saper6569/Sound-System/LtSpice/CrossoverFilterAnalysis.asc

C1: cap; 0.1µ
C2: cap; 0.1µ
C3: cap; 0.1µ
C4: cap; 0.1µ
C5: cap; 0.1µ
C6: cap; 47n
C7: cap; 47n
C8: cap; 0.1µ
R1: res; 11k
R2: res; 22k
R3: res; 11k
R4: res; 22k
R5: res; 1k
R6: res; 18k
R7: res; 30k
R8: res; 30k
R9: res; 18k
R10: res; 1k
U1: opamp
U2: opamp
U3: opamp
U4: opamp
V1: voltage; AC 1
Named nets: 0, Highs-Out, Lows-Out
.lib opamp.sub
.ac dec 20 20 20k
