saper6569/Sound-System/LtSpice/SoundSystemSpice.asc

C1: cap; 100n
C2: cap; 100n
C3: cap; 100n
C4: cap; 100n
C5: cap; 100n
C6: cap; 47n
C7: cap; 100n
C8: cap; 47n
C9: cap; 100n
C10: cap; 100n
C11: cap; 100n
C12: cap; 47n
C13: cap; 100n
C14: cap; 100n
C15: cap; 100n
C16: cap; 47n
C17: cap; 100p
C18: cap; 100p
C19: cap; 10µ
C20: cap; 10µ
C21: cap; 47n
C22: cap; 4.7n
C23: cap; 22n
C24: cap; 1n
C25: cap; 4.7n
C26: cap; 47n
C27: cap; 4.7n
C28: cap; 22n
C29: cap; 4.7n
C30: cap; 1n
C31: cap; 10µ
R1: res; 11k
R2: res; 22k
R3: res; 11k
R4: res; 22k
R5: res; 1k
R6: res; 18k
R7: res; 30k
R8: res; 30k
R9: res; 18k
R10: res; 1k
R11: res; 11k
R12: res; 22k
R13: res; 18k
R14: res; 1k
R15: res; 1k
R16: res; 30k
R17: res; 11k
R18: res; 22k
R19: res; 30k
R20: res; 1k
R21: res; 1k
R22: res; 18k
R23: res; 1k
R24: res; 1k
R25: res; {100k*b}
R26: res; {100k*(1-b)}
R27: res; 10k
R28: res; {100k*m}
R29: res; {500k*t}
R30: res; 10k
R31: res; 10k
R32: res; {100k*(1-m)}
R33: res; 3.3k
R34: res; 3.3k
R35: res; {500k*(1-t)}
R36: res; 1.8k
R37: res; 1.8k
R38: res; 270
R39: res; {100k*b}
R40: res; {100k*(1-b)}
R41: res; 10k
R42: res; 10k
R43: res; 10k
R44: res; {100k*m}
R45: res; {100k*(1-m)}
R46: res; 3.3k
R47: res; 3.3k
R48: res; {500k*t}
R49: res; {500k*(1-t)}
R50: res; 1.8k
R51: res; 1.8k
R52: res; 270
R53: res; 1k
R56: res; {10k*v}
R57: res; {10k*(1-v)}
R58: res; {10k*v}
R59: res; {10k*(1-v)}
U1: opamp
U2: opamp
U3: opamp
U4: opamp
U5: opamp
U6: opamp
U7: opamp
U8: opamp
U9: opamp
U10: opamp
U11: opamp
U12: opamp
U13: opamp
V1: voltage; wavefile="Daft-Punk-One-More-Time.wav" chan=1
V2: voltage; wavefile="Daft-Punk-One-More-Time.wav" chan=0
Named nets: 0, Left, Right, Left-Out, Right-Out, Sub-Out
.param b=0.5
.param m=0.5
.param t=0.5
 
.param v 0.9
 
.wave "l+r.wav" 16 44.1k V(Left-Out) V(Right-Out)
.wave "bass.wav" 16 44.1k V(Sub-Out) 
BLEFT  Lmix 0 V=V(Left-Out)+V(Sub-Out)
BRIGHT Rmix 0 V=V(Right-Out)+V(Sub-Out)
 
.wave "together.wav" 16 44.1k V(Lmix) V(Rmix)
 
.lib opamp.sub
.tran 10
Parameters b, m, t control the active equalizer where the letters represent bass, mid and treble respectively.
Parameter v controls the volume.
Change these parameters around to see the equalizer and volume control work.
Make sure to keep parameters between 0 and 1 exclusive.
 
For changing the input audio: 
1. Place a wav file in the same directory as the project
2. Change the directives under V1 and V2 to your wav file name, but keep chan=1 and chan=0
3. Set the .tran to be longer than the length of the wav file
 
I highly recommend trimming your audio, as simulation often takes a long time.
3 Band Baxandall 
Eqaulizer
2 Way Crossover
Subwoofer 
L+R Summer
Volume 
Control
Input
Buffer
