saper6569/Sound-System/Kicad/SoundSystem.kicad_pcb

## KiCad design Kicad/SoundSystem.kicad_pcb (2026-11-13)

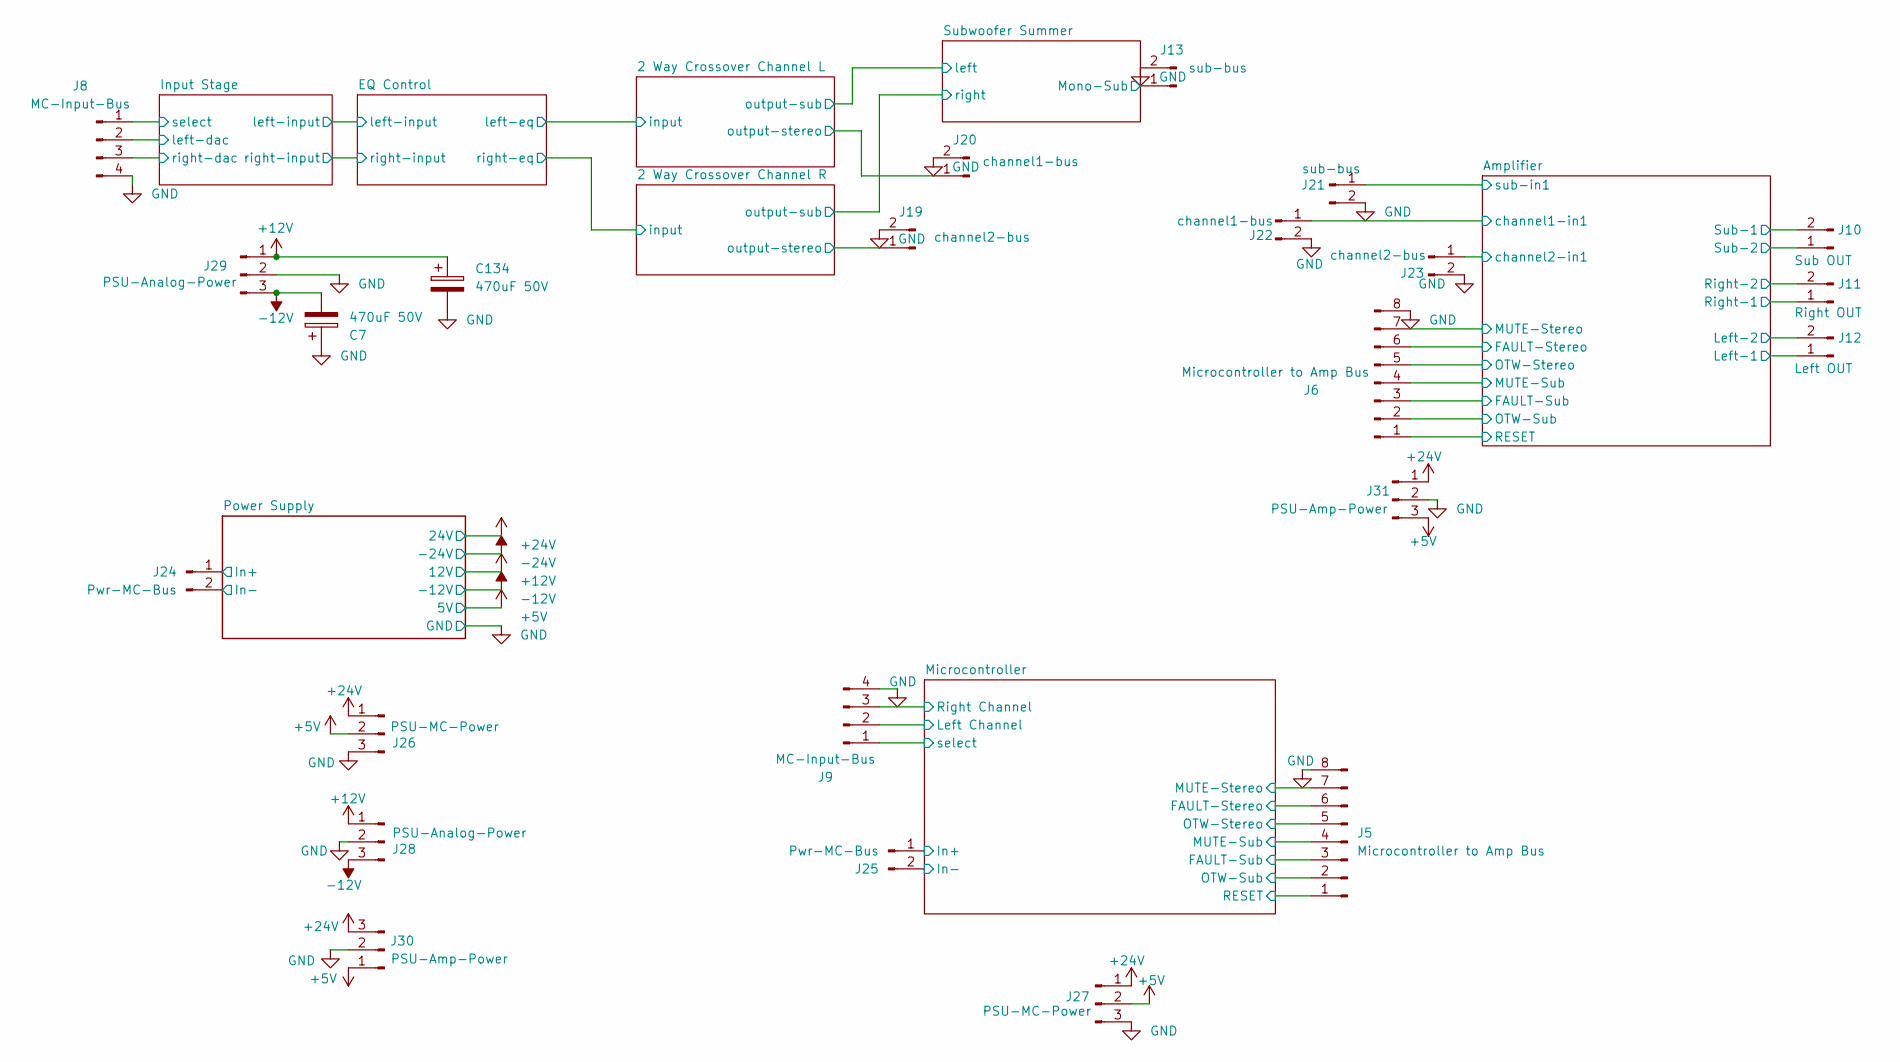
[picture p1: schematic SoundSystem.kicad_sch]

Parts:
C7, C134: 470uF 50V; CP_Radial_D12.5mm_P5.00mm; MPN NXH 50V470 12.5*20; LCSC C165672
J5, J6: Microcontroller to Amp Bus; PinHeader_1x08_P2.54mm_Vertical; MPN PZ254V-11-08P; LCSC C492407
J8, J9: MC-Input-Bus; PinHeader_1x04_P2.54mm_Vertical; MPN PZ254V-11-04P; LCSC C492403
J10: Sub OUT; TerminalBlock_Phoenix_MKDS-1,5-2-5.08_1x02_P5.08mm_Horizont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; MPN KF128-5.08-2P-AA; LCSC C474952
J11: Right OUT; TerminalBlock_Phoenix_MKDS-1,5-2-5.08_1x02_P5.08mm_Horizont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; MPN KF128-5.08-2P-AA; LCSC C474952
J12: Left OUT; TerminalBlock_Phoenix_MKDS-1,5-2-5.08_1x02_P5.08mm_Horizont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; MPN KF128-5.08-2P-AA; LCSC C474952
J13, J21: sub-bus; PinHeader_1x02_P2.54mm_Vertical; MPN PZ254V-11-02P; LCSC C492401
J19, J23: channel2-bus; PinHeader_1x02_P2.54mm_Vertical; MPN PZ254V-11-02P; LCSC C492401
J20, J22: channel1-bus; PinHeader_1x02_P2.54mm_Vertical; MPN PZ254V-11-02P; LCSC C492401
J24, J25: Pwr-MC-Bus; PinHeader_1x02_P2.54mm_Vertical; MPN PZ254V-11-02P; LCSC C492401
J26, J27: PSU-MC-Power; PinHeader_1x03_P2.54mm_Vertical; MPN PZ254V-11-03P; LCSC C2937625
J28, J29: PSU-Analog-Power; PinHeader_1x03_P2.54mm_Vertical; MPN PZ254V-11-03P; LCSC C2937625
J30, J31: PSU-Amp-Power; TerminalBlock_Phoenix_MKDS-1,5-3-5.08_1x03_P5.08mm_Horizont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; MPN KF128-5.08-3P-AA; LCSC C474953

Connections:
+12V: C134.1, J28.1, J29.1; also elsewhere on the board
-12V: C7.2, J28.3, J29.3; also elsewhere on the board
/2 Way Crossover Channel L/output-stereo: J20.1; also elsewhere on the board
/2 Way Crossover Channel R/output-stereo: J19.1; also elsewhere on the board
/Amplifier/FAULT-Stereo: J6.6; also elsewhere on the board
/Amplifier/FAULT-Sub: J6.3; also elsewhere on the board
/Amplifier/Left-1: J12.1; also elsewhere on the board
/Amplifier/Left-2: J12.2; also elsewhere on the board
/Amplifier/MUTE-Stereo: J6.7; also elsewhere on the board
/Amplifier/MUTE-Sub: J6.4; also elsewhere on the board
/Amplifier/OTW-Stereo: J6.5; also elsewhere on the board
/Amplifier/OTW-Sub: J6.2; also elsewhere on the board
/Amplifier/Right-1: J11.1; also elsewhere on the board
/Amplifier/Right-2: J11.2; also elsewhere on the board
/Amplifier/Sub-1: J10.2; also elsewhere on the board
/Amplifier/Sub-2: J10.1; also elsewhere on the board
/Amplifier/channel1-in1: J22.1; also elsewhere on the board
/Amplifier/channel2-in1: J23.1; also elsewhere on the board
/Amplifier/sub-in1: J21.1; also elsewhere on the board
/Input Stage/left-dac: J8.2; also elsewhere on the board
/Input Stage/right-dac: J8.3; also elsewhere on the board
/Input Stage/select: J8.1; also elsewhere on the board
/Microcontroller/FAULT-Stereo: J5.5; also elsewhere on the board
/Microcontroller/FAULT-Sub: J5.3; also elsewhere on the board
/Microcontroller/In+: J25.1; also elsewhere on the board
/Microcontroller/In-: J25.2; also elsewhere on the board
/Microcontroller/Left Channel: J9.2; also elsewhere on the board
/Microcontroller/MUTE-Stereo: J5.7; also elsewhere on the board
/Microcontroller/MUTE-Sub: J5.4; also elsewhere on the board
/Microcontroller/OTW-Stereo: J5.6; also elsewhere on the board
/Microcontroller/OTW-Sub: J5.2; also elsewhere on the board
/Microcontroller/RESET: J5.1; also elsewhere on the board
/Microcontroller/Right Channel: J9.3; also elsewhere on the board
/Microcontroller/select: J9.1; also elsewhere on the board
/Power Supply/In+: J24.1; also elsewhere on the board
/Subwoofer Summer/Mono-Sub: J13.1; also elsewhere on the board
GND: C7.1, C134.2, J5.8, J6.8, J8.4, J9.4, J13.2, J19.2, J20.2, J21.2, J22.2, J23.2, J26.3, J27.3, J28.2, J29.2, J30.2, J31.2; also elsewhere on the board
RESET: J6.1; also elsewhere on the board

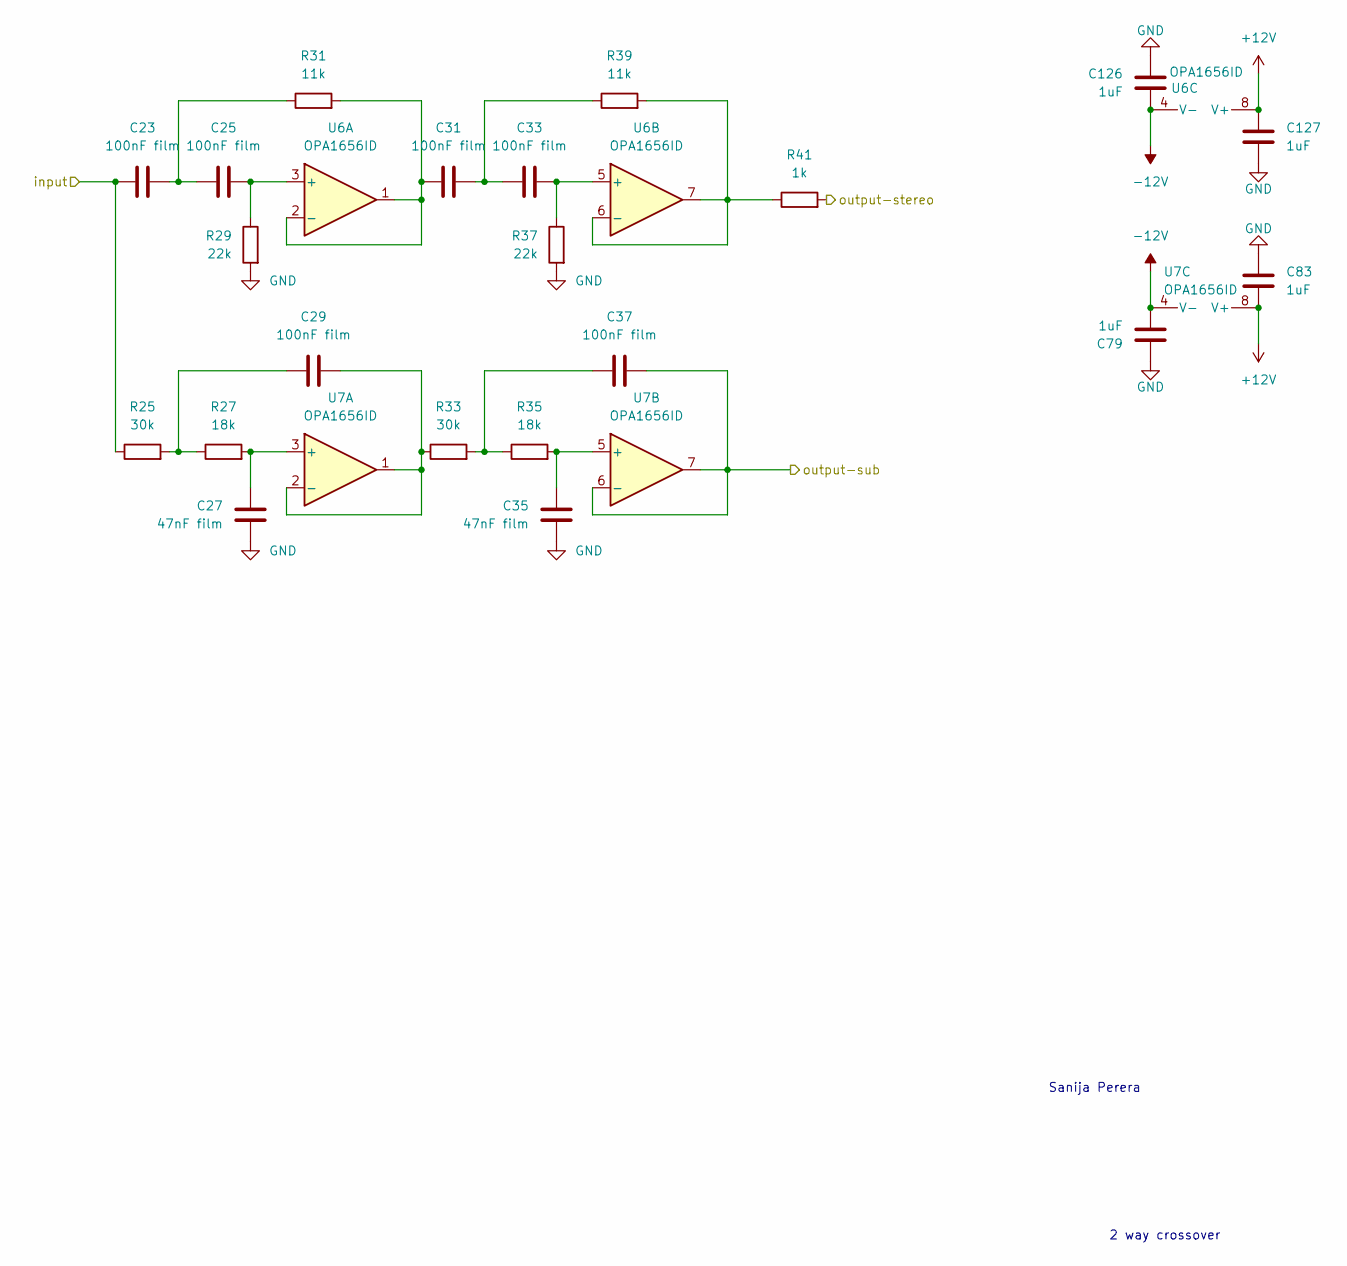
[picture p2: schematic crossover.kicad_sch]

Parts:
C23, C25, C29, C31, C33, C37: 100nF film; C_Rect_L7.2mm_W3.5mm_P5.00mm_FKS2_FKP2_MKS2_MKP2; MPN MKS2D031001A00JSSD; LCSC C415551
C27, C35: 47nF film; C_Rect_L7.2mm_W4.5mm_P5.00mm_FKS2_FKP2_MKS2_MKP2; MPN C242A473J20A201; LCSC C328859
C79, C83, C126, C127: 1uF; C_0805_2012Metric_Pad1.18x1.45mm_HandSolder; MPN CC0805KKX7R9BB105; LCSC C91185
R25, R33: 30k; R_0805_2012Metric_Pad1.20x1.40mm_HandSolder; MPN 0805W8F3002T5E; LCSC C17621
R27, R35: 18k; R_0805_2012Metric_Pad1.20x1.40mm_HandSolder; MPN 0805W8F1802T5E; LCSC C17506
R29, R37: 22k; R_0805_2012Metric_Pad1.20x1.40mm_HandSolder; MPN 0805W8F2202T5E; LCSC C17560
R31, R39: 11k; R_0805_2012Metric_Pad1.20x1.40mm_HandSolder; MPN 0805W8F1102T5E; LCSC C17429
R41: 1k; R_0805_2012Metric_Pad1.20x1.40mm_HandSolder; MPN 0805W8F1001T5E; LCSC C17513
U6, U7: OPA1656ID; SOIC-8_3.9x4.9mm_P1.27mm; MPN OPA1656IDR; LCSC C1849431

Connections:
+12V: C83.2, C127.2, U6.8 (V+), U7.8 (V+); also elsewhere on the board
-12V: C79.1, C126.1, U6.4 (V-), U7.4 (V-); also elsewhere on the board
/2 Way Crossover Channel L/input: C23.1, R25.1; also elsewhere on the board
/2 Way Crossover Channel L/output-stereo: R41.2; also elsewhere on the board
/2 Way Crossover Channel L/output-sub: C37.2, U7.6 (-), U7.7; also elsewhere on the board
GND: C27.1, C35.1, C79.2, C83.1, C126.2, C127.1, R29.2, R37.2; also elsewhere on the board
unnamed: C23.2, C25.1, R31.1
unnamed: C29.1, R25.2, R27.1
unnamed: C31.2, C33.1, R39.1
unnamed: C37.1, R33.2, R35.1
unnamed: C25.2, R29.1, U6.3 (+)
unnamed: C31.1, R31.2, U6.1, U6.2 (-)
unnamed: C33.2, R37.1, U6.5 (+)
unnamed: R39.2, R41.1, U6.6 (-), U6.7
unnamed: C27.2, R27.2, U7.3 (+)
unnamed: C29.2, R33.1, U7.1, U7.2 (-)
unnamed: C35.2, R35.2, U7.5 (+)

Parts of its further copies:
C24, C26, C30, C32, C34, C38: 100nF film; C_Rect_L7.2mm_W3.5mm_P5.00mm_FKS2_FKP2_MKS2_MKP2; MPN MKS2D031001A00JSSD; LCSC C415551
C28, C36: 47nF film; C_Rect_L7.2mm_W4.5mm_P5.00mm_FKS2_FKP2_MKS2_MKP2; MPN C242A473J20A201; LCSC C328859
C84, C85, C128, C129: 1uF; C_0805_2012Metric_Pad1.18x1.45mm_HandSolder; MPN CC0805KKX7R9BB105; LCSC C91185
R26, R34: 30k; R_0805_2012Metric_Pad1.20x1.40mm_HandSolder; MPN 0805W8F3002T5E; LCSC C17621
R28, R36: 18k; R_0805_2012Metric_Pad1.20x1.40mm_HandSolder; MPN 0805W8F1802T5E; LCSC C17506
R30, R38: 22k; R_0805_2012Metric_Pad1.20x1.40mm_HandSolder; MPN 0805W8F2202T5E; LCSC C17560
R32, R40: 11k; R_0805_2012Metric_Pad1.20x1.40mm_HandSolder; MPN 0805W8F1102T5E; LCSC C17429
R42: 1k; R_0805_2012Metric_Pad1.20x1.40mm_HandSolder; MPN 0805W8F1001T5E; LCSC C17513
U8, U9: OPA1656ID; SOIC-8_3.9x4.9mm_P1.27mm; MPN OPA1656IDR; LCSC C1849431

Connections of its further copies:
+12V: C85.2, C129.2, U8.8 (V+), U9.8 (V+); also elsewhere on the board
-12V: C84.1, C128.1, U8.4 (V-), U9.4 (V-); also elsewhere on the board
/2 Way Crossover Channel R/input: C24.1, R26.1; also elsewhere on the board
/2 Way Crossover Channel R/output-stereo: R42.2; also elsewhere on the board
/2 Way Crossover Channel R/output-sub: C38.2, U9.6 (-), U9.7; also elsewhere on the board
GND: C28.1, C36.1, C84.2, C85.1, C128.2, C129.1, R30.2, R38.2; also elsewhere on the board
unnamed: C24.2, C26.1, R32.1
unnamed: C30.1, R26.2, R28.1
unnamed: C32.2, C34.1, R40.1
unnamed: C38.1, R34.2, R36.1
unnamed: C26.2, R30.1, U8.3 (+)
unnamed: C32.1, R32.2, U8.1, U8.2 (-)
unnamed: C34.2, R38.1, U8.5 (+)
unnamed: R40.2, R42.1, U8.6 (-), U8.7
unnamed: C28.2, R28.2, U9.3 (+)
unnamed: C30.2, R34.1, U9.1, U9.2 (-)
unnamed: C36.2, R36.2, U9.5 (+)

Notes on the sheet:
2 way crossover
Sanija Perera

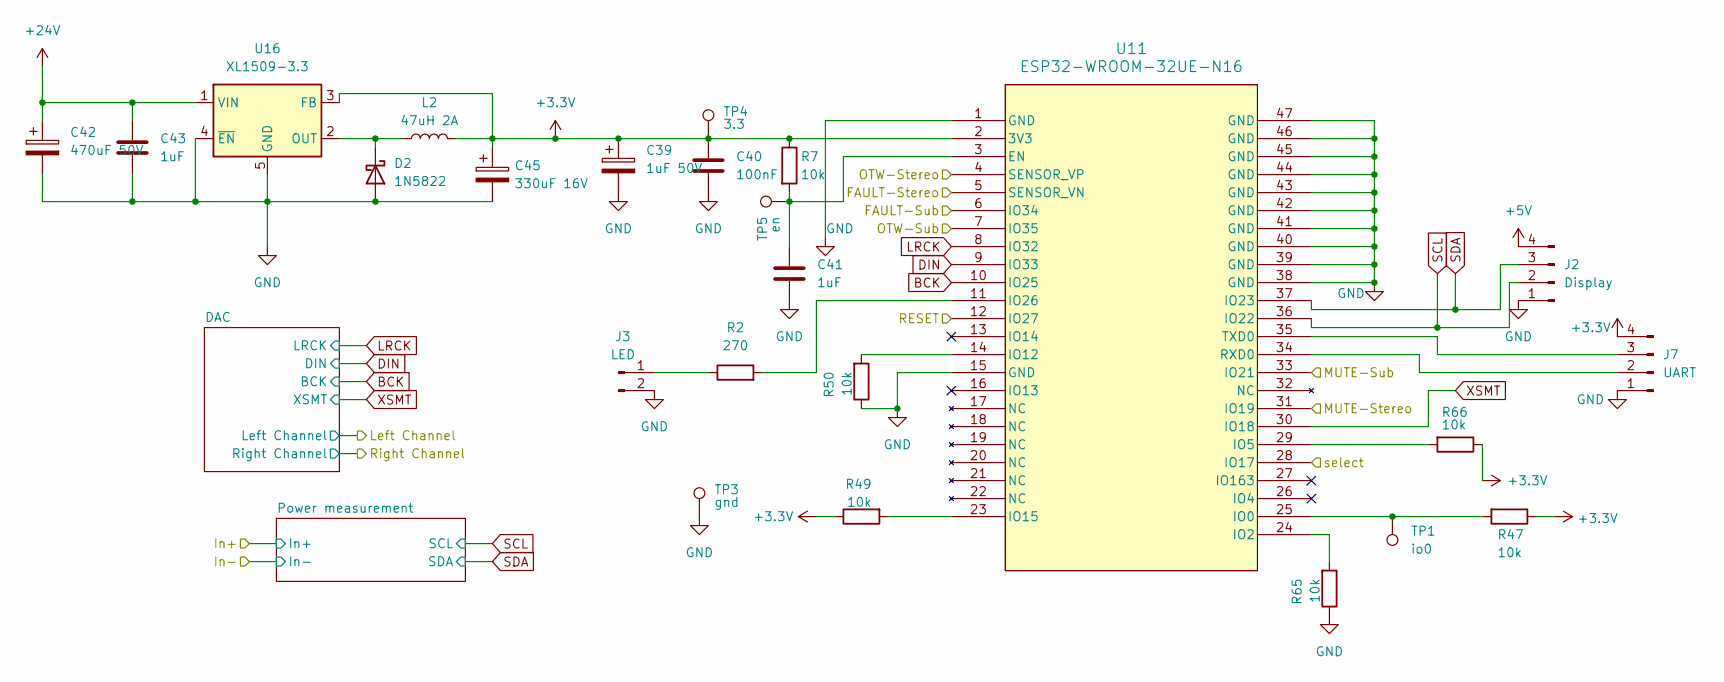
[picture p3: schematic esp32.kicad_sch]

Parts:
C39: 1uF 50V; CP_Elec_4x5.4; MPN MVK50V1M4*5 4.0TP; LCSC C346963
C40: 100nF; C_0805_2012Metric_Pad1.18x1.45mm_HandSolder; MPN CC0805KRX7R9BB104; LCSC C49678
C41: 1uF; C_0805_2012Metric_Pad1.18x1.45mm_HandSolder; MPN CC0805KKX7R9BB105; LCSC C91185
C42: 470uF 50V; CP_Radial_D12.5mm_P5.00mm; MPN NXH 50V470 12.5*20; LCSC C165672
C43: 1uF; C_1206_3216Metric_Pad1.33x1.80mm_HandSolder; MPN CC1206KKX7R9BB105; LCSC C107185
C45: 330uF 16V; CP_Elec_8x10; MPN MVK16V330M8*10 8.0TP; LCSC C2835680
D2: 1N5822; D_DO-27_P12.70mm_Horizontal; MPN 1N5822; LCSC C2476
J2: Display; PinHeader_1x04_P2.54mm_Vertical; MPN PZ254V-11-04P; LCSC C492403
J3: LED; PinHeader_1x02_P2.54mm_Vertical; MPN PZ254V-11-02P; LCSC C492401
J7: UART; PinHeader_1x04_P2.54mm_Vertical; MPN PZ254V-11-04P; LCSC C492403
L2: 47uH 2A; L_Bourns_SRR1260; MPN SRR1260-470M; LCSC C1329363
R2: 270; R_0805_2012Metric_Pad1.20x1.40mm_HandSolder; MPN 0805W8F2700T5E; LCSC C17590
R7, R47, R49, R50, R65, R66: 10k; R_0805_2012Metric_Pad1.20x1.40mm_HandSolder; MPN 0805W8F1002T5E; LCSC C17414
TP1: io0; TestPoint_Pad_1.0x1.0mm; MPN (PCB pad)
TP3: gnd; TestPoint_Pad_1.0x1.0mm; MPN (PCB pad)
TP4: 3.3; TestPoint_Pad_1.0x1.0mm; MPN (PCB pad)
TP5: en; TestPoint_Pad_1.0x1.0mm; MPN (PCB pad)
U11: ESP32-WROOM-32UE-N16; ESP32-32UE_EXP; MPN ESP32-WROOM-32UE-N16; LCSC C701346
U16: XL1509-3.3; SOIC-8_3.9x4.9mm_P1.27mm; MPN XL1509-3.3E1; LCSC C74193

Connections:
+3.3V: C39.1, C40.1, C45.1, J7.4, L2.2, R7.1, R47.1, R49.1, R66.1, TP4.1 (1_1), U11.2 (3V3), U16.3 (FB); also elsewhere on the board
/Microcontroller/FAULT-Stereo: U11.5 (SENSOR_VN); also elsewhere on the board
/Microcontroller/FAULT-Sub: U11.6 (IO34); also elsewhere on the board
/Microcontroller/MUTE-Stereo: U11.31 (IO19); also elsewhere on the board
/Microcontroller/MUTE-Sub: U11.33 (IO21); also elsewhere on the board
/Microcontroller/OTW-Stereo: U11.4 (SENSOR_VP); also elsewhere on the board
/Microcontroller/OTW-Sub: U11.7 (IO35); also elsewhere on the board
/Microcontroller/RESET: U11.12 (IO27); also elsewhere on the board
/Microcontroller/select: U11.28 (IO17); also elsewhere on the board
BCK: U11.10 (IO25); also elsewhere on the board
DIN: U11.9 (IO33); also elsewhere on the board
GND: C39.2, C40.2, C41.2, C42.2, C43.2, C45.2, D2.2 (A), J2.1, J3.2, J7.1, R50.1, R65.1, TP3.1 (1_1), U11.1 (GND), U11.15 (GND), U11.38 (GND), U11.39 (GND), U11.40 (GND), U11.41 (GND), U11.42 (GND), U11.43 (GND), U11.44 (GND), U11.45 (GND), U11.46 (GND), U11.47 (GND), U16.4 (~EN), U16.5 (GND), U16.6 (GND), U16.7 (GND), U16.8 (GND); also elsewhere on the board
LRCK: U11.8 (IO32); also elsewhere on the board
unnamed: D2.1 (K), L2.1, U16.2 (OUT)
unnamed: J3.1, R2.1
unnamed: J7.2, U11.34 (RXD0)
unnamed: J7.3, U11.35 (TXD0)
unnamed: C41.1, R7.2, TP5.1 (1_1), U11.3 (EN)
unnamed: R47.2, TP1.1 (1_1), U11.25 (IO0)
unnamed: R65.2, U11.24 (IO2)
unnamed: R66.2, U11.29 (IO5)
unnamed: R50.2, U11.14 (IO12)
unnamed: R49.2, U11.23 (IO15)
unnamed: R2.2, U11.11 (IO26)
SCL: J2.2, U11.36 (IO22); also elsewhere on the board
SDA: J2.3, U11.37 (IO23); also elsewhere on the board
XSMT: U11.30 (IO18); also elsewhere on the board

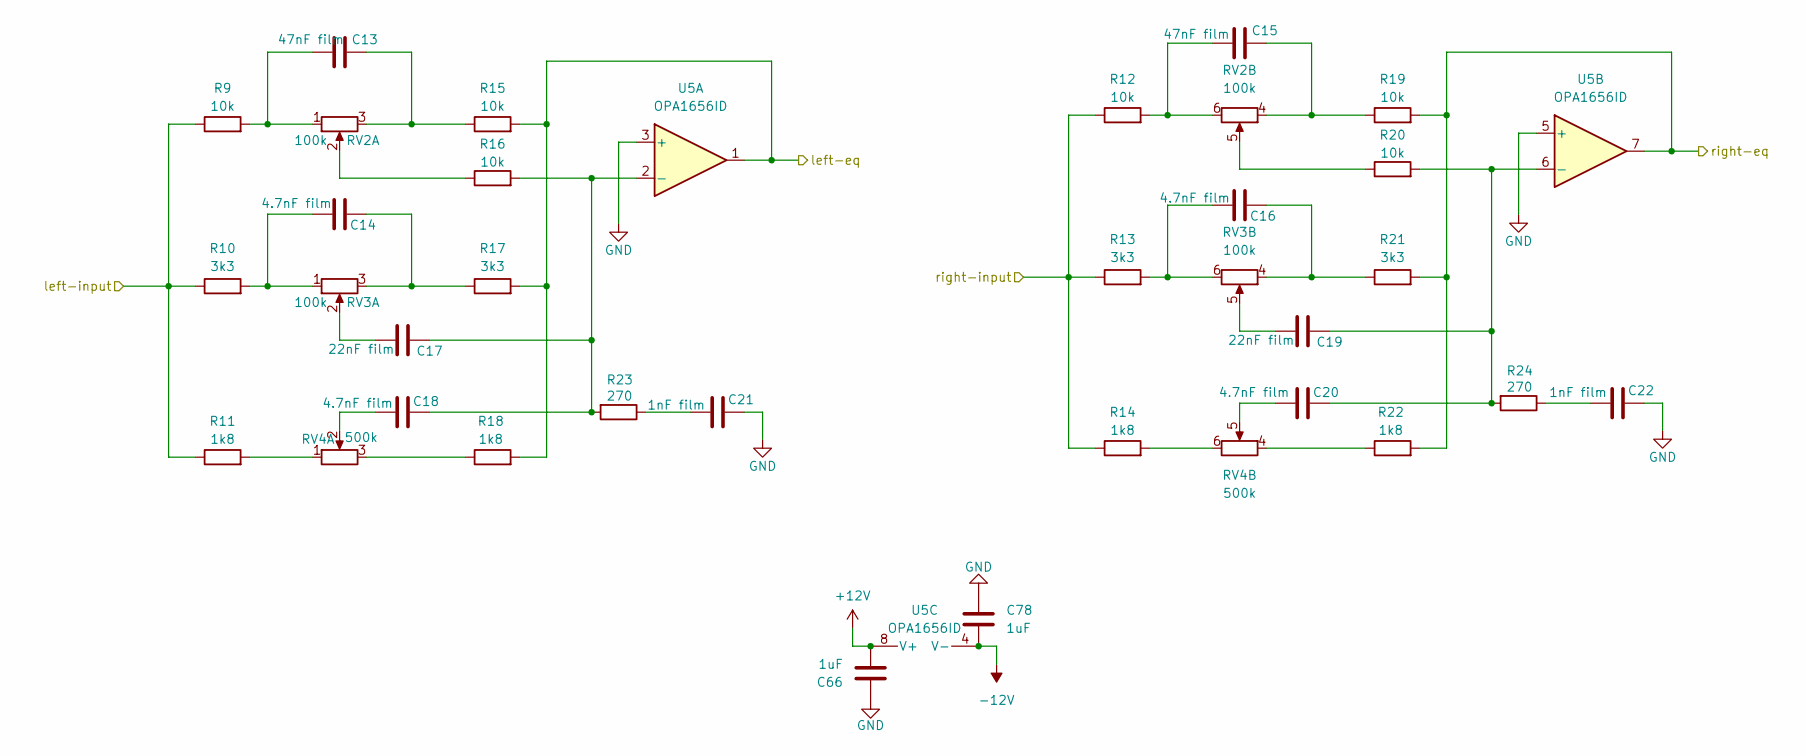
[picture p4: schematic EQ.kicad_sch]

Parts:
C13, C15: 47nF film; C_Rect_L7.2mm_W4.5mm_P5.00mm_FKS2_FKP2_MKS2_MKP2; MPN C242A473J20A201; LCSC C328859
C14, C16, C18, C20: 4.7nF film; C_Rect_L7.2mm_W3.5mm_P5.00mm_FKS2_FKP2_MKS2_MKP2; MPN C242A472J20A201; LCSC C401257
C17, C19: 22nF film; C_Rect_L7.2mm_W3.5mm_P5.00mm_FKS2_FKP2_MKS2_MKP2; MPN C242A223J20A201; LCSC C328834
C21, C22: 1nF film; C_Rect_L7.2mm_W3.5mm_P5.00mm_FKS2_FKP2_MKS2_MKP2; MPN C242A102J20C000; LCSC C280714
C66, C78: 1uF; C_0805_2012Metric_Pad1.18x1.45mm_HandSolder; MPN CC0805KKX7R9BB105; LCSC C91185
R9, R12, R15, R16, R19, R20: 10k; R_0805_2012Metric_Pad1.20x1.40mm_HandSolder; MPN 0805W8F1002T5E; LCSC C17414
R10, R13, R17, R21: 3k3; R_0805_2012Metric_Pad1.20x1.40mm_HandSolder; MPN 0805W8F3301T5E; LCSC C26010
R11, R14, R18, R22: 1k8; R_1206_3216Metric_Pad1.30x1.75mm_HandSolder; MPN 1206W4F1801T5E; LCSC C22108
R23, R24: 270; R_0805_2012Metric_Pad1.20x1.40mm_HandSolder; MPN 0805W8F2700T5E; LCSC C17590
RV2, RV3: 100k; 10k pot; MPN 16mm dual-gang pot (A10K / B100K / B100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
RV4: 500k; 10k pot; MPN 16mm dual-gang pot (A10K / B100K / B100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
U5: OPA1656ID; SOIC-8_3.9x4.9mm_P1.27mm; MPN OPA1656IDR; LCSC C1849431

Connections:
+12V: C66.1, U5.8 (V+); also elsewhere on the board
-12V: C78.2, U5.4 (V-); also elsewhere on the board
/2 Way Crossover Channel L/input: R15.2, R17.2, R18.2, U5.1; also elsewhere on the board
/2 Way Crossover Channel R/input: R19.2, R21.2, R22.2, U5.7; also elsewhere on the board
/EQ Control/left-input: R9.1, R10.1, R11.1; also elsewhere on the board
/EQ Control/right-input: R12.1, R13.1, R14.1; also elsewhere on the board
GND: C21.1, C22.1, C66.2, C78.1, U5.3 (+), U5.5 (+); also elsewhere on the board
unnamed: C13.1, R9.2, RV2.1
unnamed: C13.2, R15.1, RV2.3
unnamed: C14.1, R10.2, RV3.1
unnamed: C14.2, R17.1, RV3.3
unnamed: C15.1, R12.2, RV2.6
unnamed: C15.2, R19.1, RV2.4
unnamed: C16.1, R13.2, RV3.6
unnamed: C16.2, R21.1, RV3.4
unnamed: C17.1, RV3.2
unnamed: C18.1, RV4.2
unnamed: C19.1, RV3.5
unnamed: C20.1, RV4.5
unnamed: C21.2, R23.1
unnamed: C22.2, R24.1
unnamed: R11.2, RV4.1
unnamed: R14.2, RV4.6
unnamed: R16.1, RV2.2
unnamed: R18.1, RV4.3
unnamed: R20.1, RV2.5
unnamed: R22.1, RV4.4
unnamed: C17.2, C18.2, R16.2, R23.2, U5.2 (-)
unnamed: C19.2, C20.2, R20.2, R24.2, U5.6 (-)

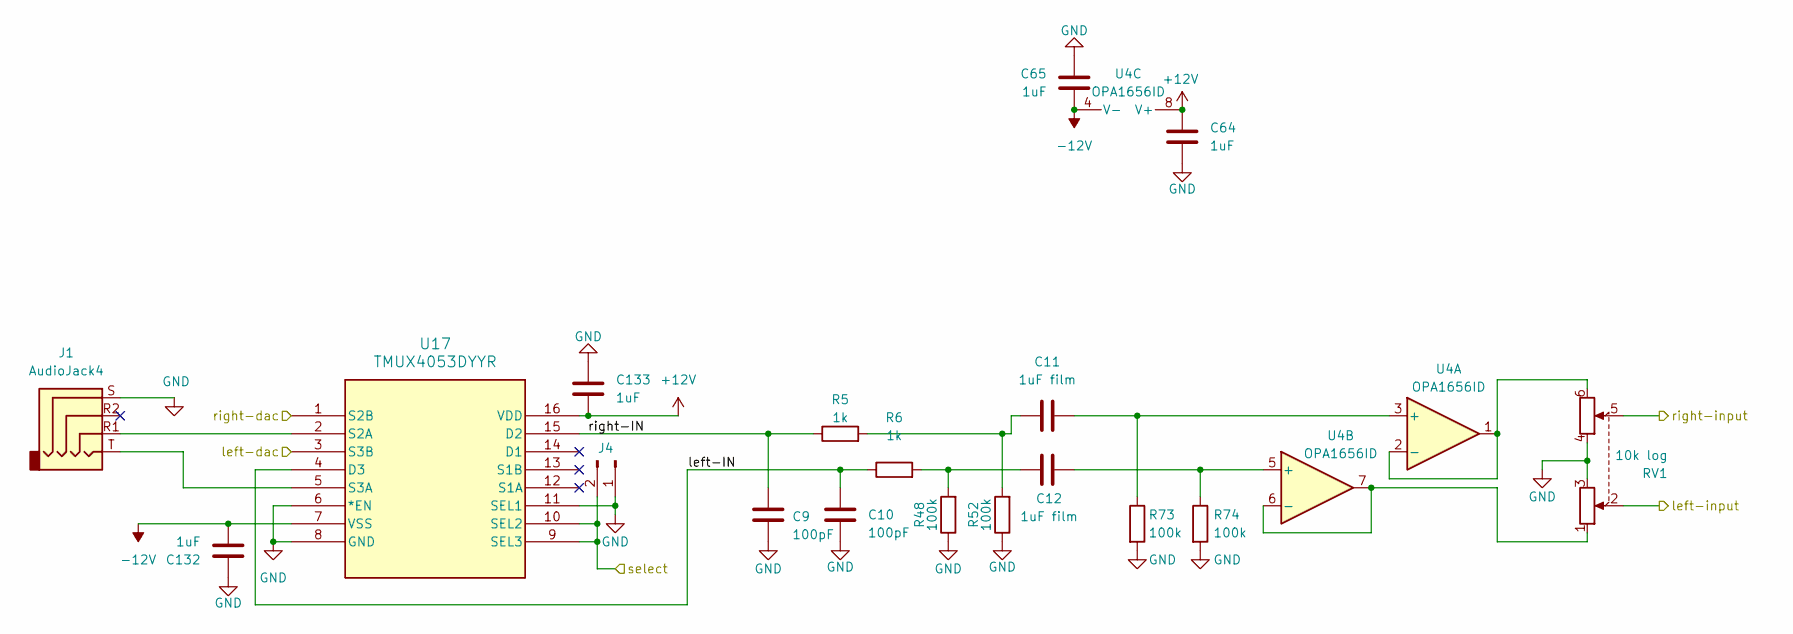
[picture p5: schematic input.kicad_sch]

Parts:
C9, C10: 100pF; C_0805_2012Metric_Pad1.18x1.45mm_HandSolder; MPN CC0805JRNPO9BN101; LCSC C62768
C11, C12: 1uF film; C_Rect_L7.2mm_W5.5mm_P5.00mm_FKS2_FKP2_MKS2_MKP2; MPN B32529C0105J289; LCSC C125386
C64, C65, C132, C133: 1uF; C_0805_2012Metric_Pad1.18x1.45mm_HandSolder; MPN CC0805KKX7R9BB105; LCSC C91185
J1: AudioJack4; Jack_3.5mm_KoreanHropartsElec_PJ-320D-4A_Horizontal; MPN PJ-320D-4A; LCSC C95562
J4: Conn_01x02_Pin; PinHeader_1x02_P2.54mm_Vertical; MPN PZ254V-11-02P; LCSC C492401
R5, R6: 1k; R_0805_2012Metric_Pad1.20x1.40mm_HandSolder; MPN 0805W8F1001T5E; LCSC C17513
R48, R52, R73, R74: 100k; R_0805_2012Metric_Pad1.20x1.40mm_HandSolder; MPN 0805W8F1003T5E; LCSC C17407
RV1: 10k log; 10k pot; MPN 16mm dual-gang pot (A10K / B100K / B100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
U4: OPA1656ID; SOIC-8_3.9x4.9mm_P1.27mm; MPN OPA1656IDR; LCSC C1849431
U17: TMUX4053DYYR; C22388988_SOT-23-THIN-16_L4_2-W2_0-P0_50-LS3_2-BR; MPN TMUX4053DYYR; LCSC C22388988

Connections:
+12V: C64.2, C133.2, U4.8 (V+), U17.16 (VDD); also elsewhere on the board
-12V: C65.1, C132.1, U4.4 (V-), U17.7 (VSS); also elsewhere on the board
/EQ Control/left-input: RV1.2; also elsewhere on the board
/EQ Control/right-input: RV1.5; also elsewhere on the board
/Input Stage/left-IN: C10.1, R6.1, U17.4 (D3)
/Input Stage/left-dac: U17.3 (S3B); also elsewhere on the board
/Input Stage/right-IN: C9.1, R5.1, U17.15 (D2)
/Input Stage/right-dac: U17.1 (S2B); also elsewhere on the board
/Input Stage/select: J4.2, U17.9 (SEL3), U17.10 (SEL2); also elsewhere on the board
GND: C9.2, C10.2, C64.1, C65.2, C132.2, C133.1, J1.S, J4.1, R48.1, R52.1, R73.2, R74.2, RV1.3, RV1.4, U17.6 (*EN), U17.8 (GND), U17.11 (SEL1); also elsewhere on the board
unnamed: C11.1, R5.2, R52.2
unnamed: C12.1, R6.2, R48.2
unnamed: C11.2, R73.1, U4.3 (+)
unnamed: RV1.6, U4.1, U4.2 (-)
unnamed: C12.2, R74.1, U4.5 (+)
unnamed: RV1.1, U4.6 (-), U4.7
unnamed: J1.R1, U17.2 (S2A)
unnamed: J1.T, U17.5 (S3A)

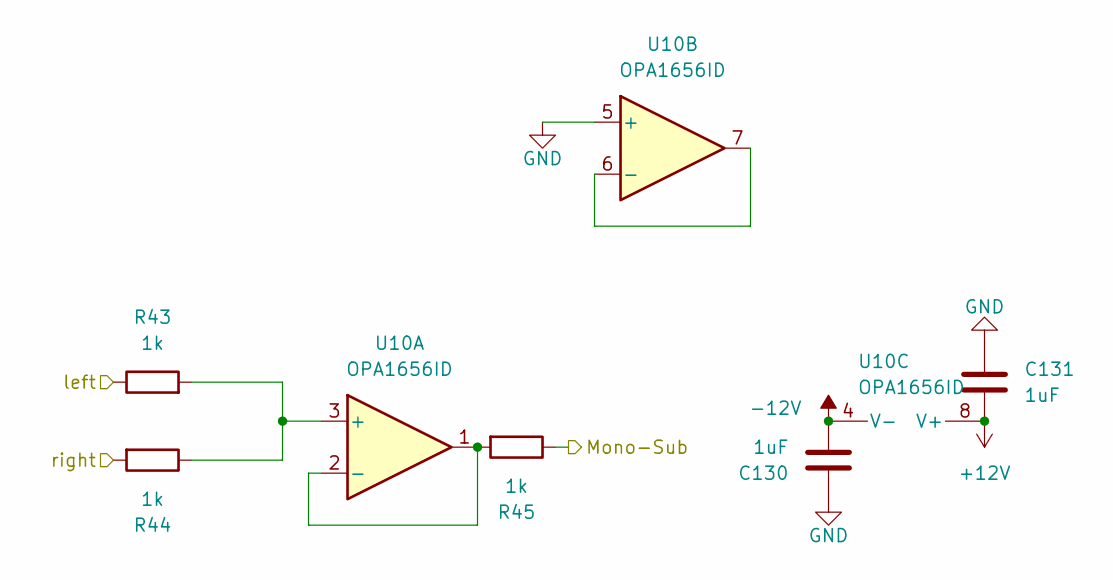
[picture p6: schematic untitled.kicad_sch]

Parts:
C130, C131: 1uF; C_0805_2012Metric_Pad1.18x1.45mm_HandSolder; MPN CC0805KKX7R9BB105; LCSC C91185
R43, R44, R45: 1k; R_0805_2012Metric_Pad1.20x1.40mm_HandSolder; MPN 0805W8F1001T5E; LCSC C17513
U10: OPA1656ID; SOIC-8_3.9x4.9mm_P1.27mm; MPN OPA1656IDR; LCSC C1849431

Connections:
+12V: C131.2, U10.8 (V+); also elsewhere on the board
-12V: C130.1, U10.4 (V-); also elsewhere on the board
/2 Way Crossover Channel L/output-sub: R43.1; also elsewhere on the board
/2 Way Crossover Channel R/output-sub: R44.2; also elsewhere on the board
/Subwoofer Summer/Mono-Sub: R45.1; also elsewhere on the board
GND: C130.2, C131.1, U10.5 (+); also elsewhere on the board
unnamed: R43.2, R44.1, U10.3 (+)
unnamed: R45.2, U10.1, U10.2 (-)
unnamed: U10.6 (-), U10.7

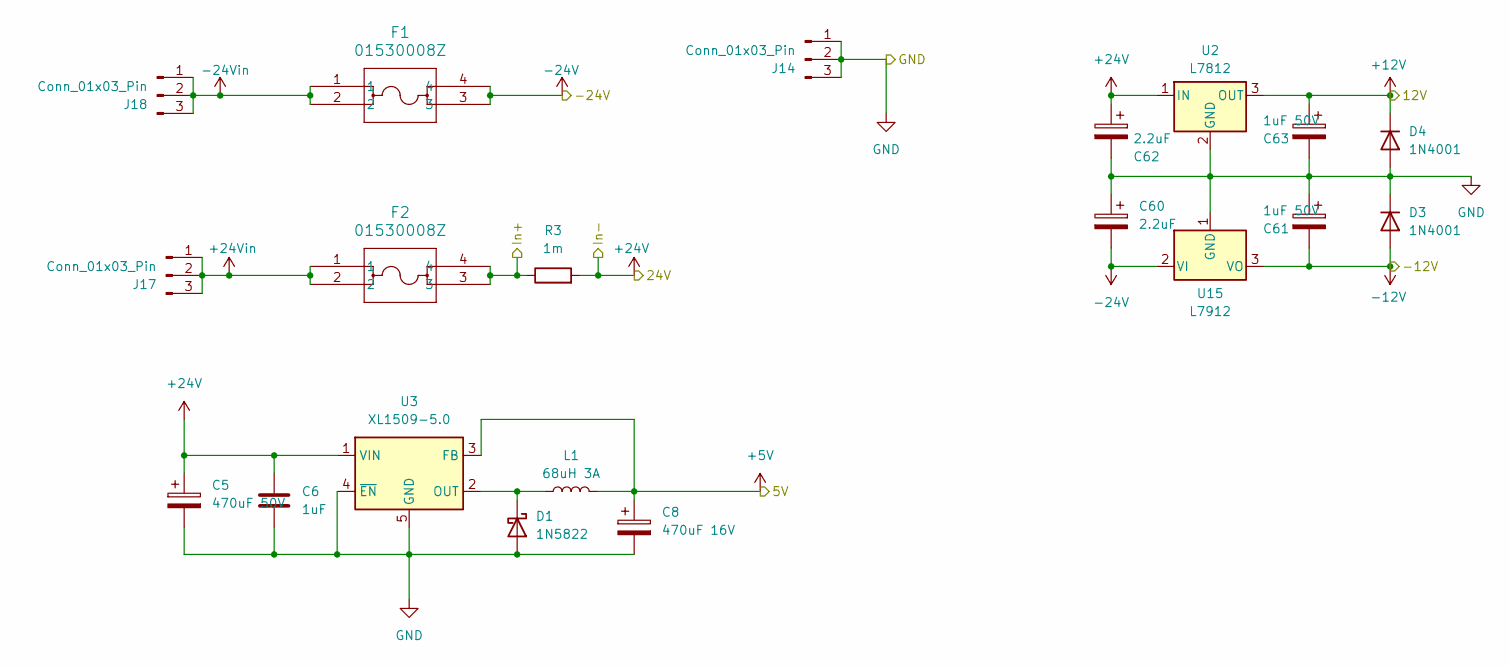
[picture p7: schematic psu.kicad_sch]

Parts:
C5: 470uF 50V; CP_Radial_D12.5mm_P5.00mm; MPN NXH 50V470 12.5*20; LCSC C165672
C6: 1uF; C_1206_3216Metric_Pad1.33x1.80mm_HandSolder; MPN CC1206KKX7R9BB105; LCSC C107185
C8: 470uF 16V; CP_Elec_10x10; MPN RYRVT16V470UF10*10; LCSC C48970774
C60, C62: 2.2uF; C_1206_3216Metric_Pad1.33x1.80mm_HandSolder; MPN CC1206KKX7R9BB225; LCSC C133050
C61, C63: 1uF 50V; CP_Elec_4x5.4; MPN MVK50V1M4*5 4.0TP; LCSC C346963
D1: 1N5822; D_DO-27_P12.70mm_Horizontal; MPN 1N5822; LCSC C2476
D3, D4: 1N4001; D_SMA_Handsoldering; MPN 1N4001; LCSC C727079
F1, F2: 01530008Z; Fuseholder_Blade_Mini_Littelfuse_01530008; MPN 01530008Z; LCSC C206907
J14, J17, J18: Conn_01x03_Pin; TerminalBlock_Phoenix_MKDS-1,5-3-5.08_1x03_P5.08mm_Horizont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; MPN KF128-5.08-3P-AA; LCSC C474953
L1: 68uH 3A; L_Bourns_SRR1210A; MPN SRR1210-680M; LCSC C2041823
R3: 1m; R_2512_6332Metric_Pad1.40x3.35mm_HandSolder; MPN LR2512D-3W-1mR-1%; LCSC C500734
U2: L7812; TO-220-3_Vertical; MPN L7812CV-DG; LCSC C2914
U3: XL1509-5.0; SOIC-8_3.9x4.9mm_P1.27mm; MPN XL1509-5.0E1; LCSC C61063
U15: L7912; TO-220-3_Vertical; MPN L7912CV-DG; LCSC C3797

Connections:
+12V: C63.1, D4.1 (K), U2.3 (OUT); also elsewhere on the board
+24Vin: F2.1, F2.2, J17.1, J17.2, J17.3
-12V: C61.2, D3.2 (A), U15.3 (VO); also elsewhere on the board
-24V: C60.2, F1.3, F1.4, U15.2 (VI)
-24Vin: F1.1, F1.2, J18.1, J18.2, J18.3
/Power Supply/In+: F2.3, F2.4, R3.1; also elsewhere on the board
GND: C5.2, C6.2, C8.2, C60.1, C61.1, C62.2, C63.2, D1.2 (A), D3.1 (K), D4.2 (A), J14.1, J14.2, J14.3, U2.2 (GND), U3.4 (~EN), U3.5 (GND), U3.6 (GND), U3.7 (GND), U3.8 (GND), U15.1 (GND); also elsewhere on the board
unnamed: D1.1 (K), L1.1, U3.2 (OUT)
