saper6569/Sound-System/Kicad/SoundSystem.kicad_pcb

## KiCad design Kicad/SoundSystem.kicad_pcb (continued)

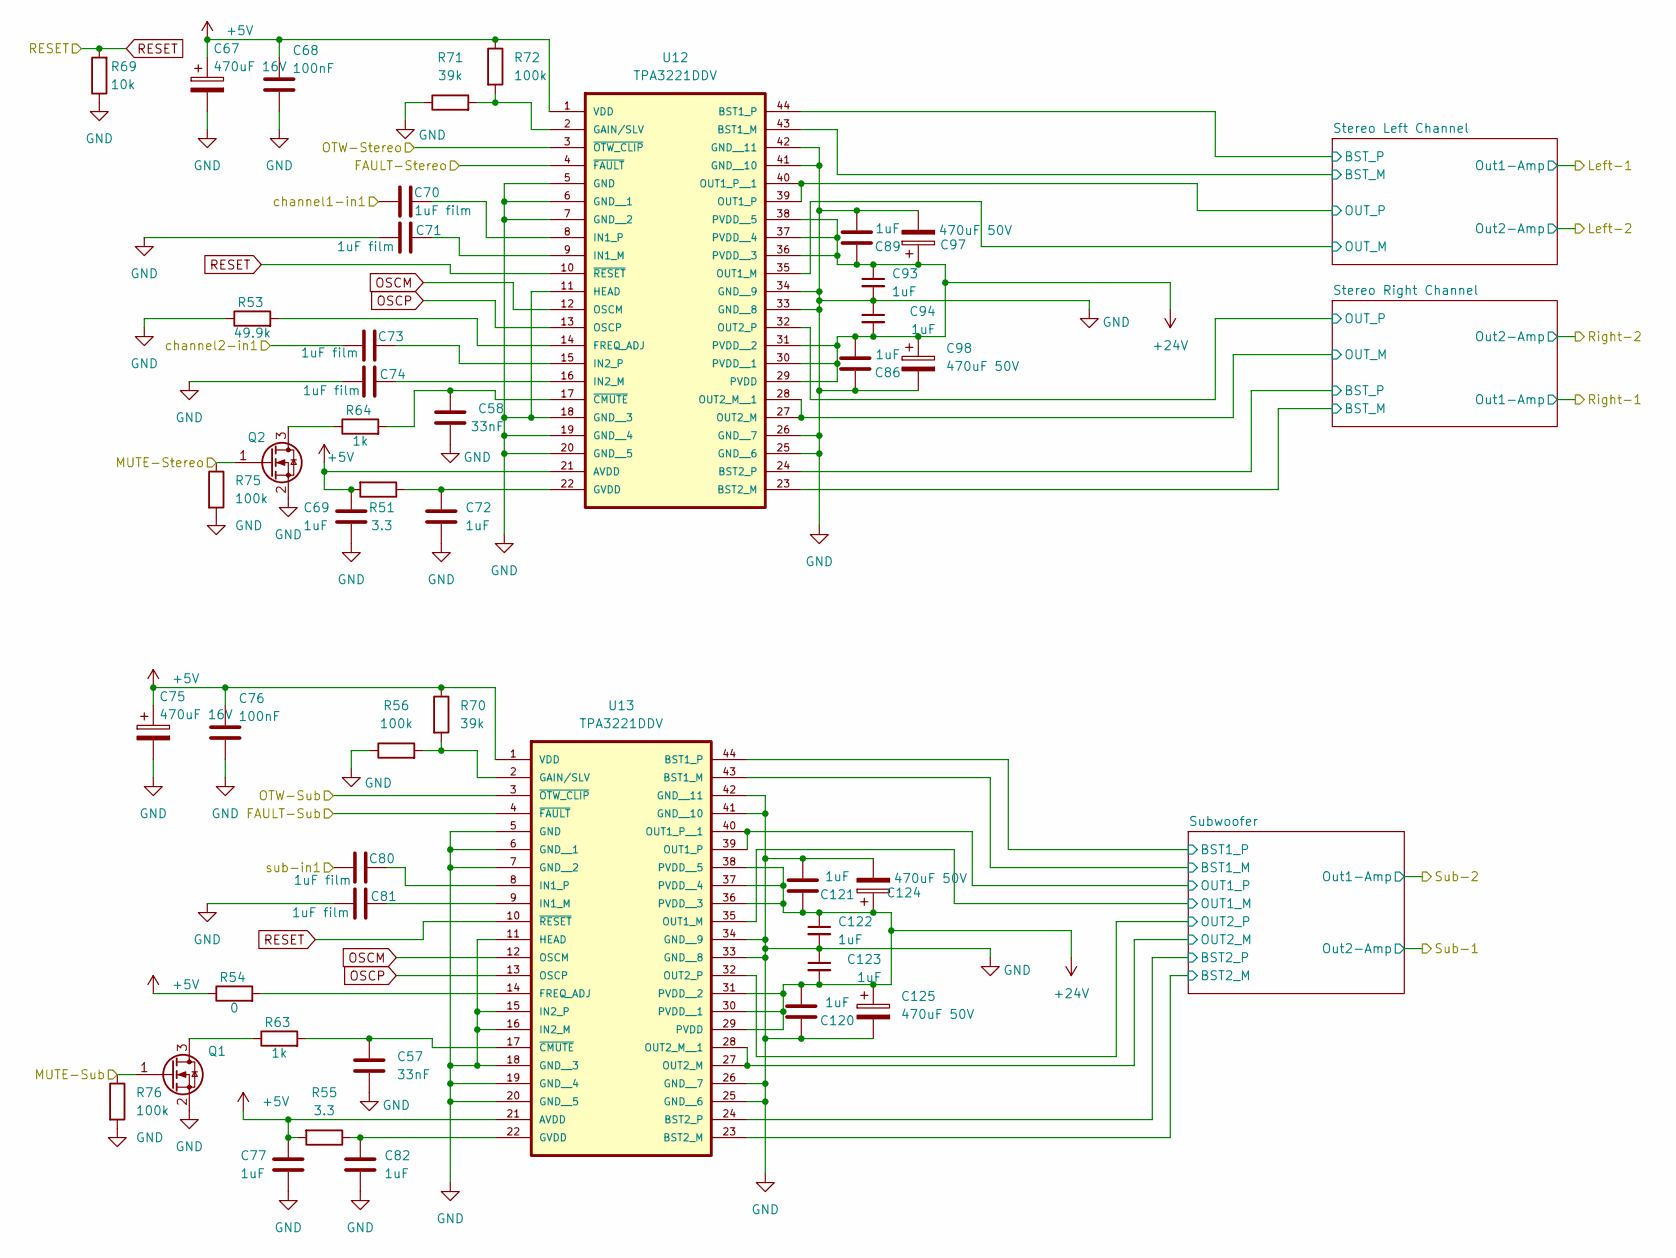
[picture p8: schematic amp.kicad_sch]

Parts:
C57, C58: 33nF; C_0805_2012Metric_Pad1.18x1.45mm_HandSolder; MPN CC0805KRX7R9BB333; LCSC C107150
C67, C75: 470uF 16V; CP_Elec_10x10; MPN RYRVT16V470UF10*10; LCSC C48970774
C68, C76: 100nF; C_0805_2012Metric_Pad1.18x1.45mm_HandSolder; MPN CC0805KRX7R9BB104; LCSC C49678
C69, C72, C77, C82: 1uF; C_0805_2012Metric_Pad1.18x1.45mm_HandSolder; MPN CC0805KKX7R9BB105; LCSC C91185
C70, C71, C73, C74, C80, C81: 1uF film; C_Rect_L7.2mm_W5.5mm_P5.00mm_FKS2_FKP2_MKS2_MKP2; MPN B32529C0105J289; LCSC C125386
C86, C89, C93, C94, C120, C121, C122, C123: 1uF; C_1206_3216Metric_Pad1.33x1.80mm_HandSolder; MPN CC1206KKX7R9BB105; LCSC C107185
C97, C98, C124, C125: 470uF 50V; CP_Radial_D12.5mm_P5.00mm; MPN NXH 50V470 12.5*20; LCSC C165672
Q1, Q2: 2N7002; TO-236AB_SOT23_NEX; MPN 2N7002; LCSC C8545
R51, R55: 3.3; R_0603_1608Metric_Pad0.98x0.95mm_HandSolder; MPN 0603WAF330KT5E; LCSC C22979
R53: 49.9k; R_0805_2012Metric_Pad1.20x1.40mm_HandSolder; MPN 0805W8F4992T5E; LCSC C17719
R54: 0; R_0805_2012Metric_Pad1.20x1.40mm_HandSolder; MPN 0805W8F0000T5E; LCSC C17477
R56, R72: 100k; R_0603_1608Metric_Pad0.98x0.95mm_HandSolder; MPN 0603WAF1003T5E; LCSC C25803
R63, R64: 1k; R_0805_2012Metric_Pad1.20x1.40mm_HandSolder; MPN 0805W8F1001T5E; LCSC C17513
R69: 10k; R_0805_2012Metric_Pad1.20x1.40mm_HandSolder; MPN 0805W8F1002T5E; LCSC C17414
R70, R71: 39k; R_0805_2012Metric_Pad1.20x1.40mm_HandSolder; MPN 0805W8F3902T5E; LCSC C25826
R75, R76: 100k; R_0805_2012Metric_Pad1.20x1.40mm_HandSolder; MPN 0805W8F1003T5E; LCSC C17407
U12, U13: TPA3221DDV; MPN TPA3221DDVR; LCSC C475500

Connections:
/Amplifier/FAULT-Stereo: U12.4 (~FAULT); also elsewhere on the board
/Amplifier/FAULT-Sub: U13.4 (~FAULT); also elsewhere on the board
/Amplifier/MUTE-Stereo: Q2.1 (G), R75.1; also elsewhere on the board
/Amplifier/MUTE-Sub: Q1.1 (G), R76.1; also elsewhere on the board
/Amplifier/OTW-Stereo: U12.3 (~OTW_CLIP); also elsewhere on the board
/Amplifier/OTW-Sub: U13.3 (~OTW_CLIP); also elsewhere on the board
/Amplifier/Stereo Left Channel/BST_M: U12.43 (BST1_M); also elsewhere on the board
/Amplifier/Stereo Left Channel/BST_P: U12.44 (BST1_P); also elsewhere on the board
/Amplifier/Stereo Left Channel/OUT_M: U12.35 (OUT1_M); also elsewhere on the board
/Amplifier/Stereo Left Channel/OUT_P: U12.39 (OUT1_P), U12.40 (OUT1_P__1); also elsewhere on the board
/Amplifier/Stereo Right Channel/BST_M: U12.23 (BST2_M); also elsewhere on the board
/Amplifier/Stereo Right Channel/BST_P: U12.24 (BST2_P); also elsewhere on the board
/Amplifier/Stereo Right Channel/OUT_M: U12.27 (OUT2_M), U12.28 (OUT2_M__1); also elsewhere on the board
/Amplifier/Stereo Right Channel/OUT_P: U12.32 (OUT2_P); also elsewhere on the board
/Amplifier/Subwoofer/BST1_M: U13.43 (BST1_M); also elsewhere on the board
/Amplifier/Subwoofer/BST1_P: U13.44 (BST1_P); also elsewhere on the board
/Amplifier/Subwoofer/BST2_M: U13.23 (BST2_M); also elsewhere on the board
/Amplifier/Subwoofer/BST2_P: U13.24 (BST2_P); also elsewhere on the board
/Amplifier/Subwoofer/OUT1_M: U13.27 (OUT2_M), U13.28 (OUT2_M__1), U13.35 (OUT1_M); also elsewhere on the board
/Amplifier/Subwoofer/OUT1_P: U13.32 (OUT2_P), U13.39 (OUT1_P), U13.40 (OUT1_P__1); also elsewhere on the board
/Amplifier/channel1-in1: C70.1; also elsewhere on the board
/Amplifier/channel2-in1: C73.1; also elsewhere on the board
/Amplifier/sub-in1: C80.1; also elsewhere on the board
GND: C57.2, C58.2, C67.2, C68.2, C69.2, C71.1, C72.2, C74.1, C75.2, C76.2, C77.2, C81.1, C82.2, C86.1, C89.2, C93.2, C94.1, C97.2, C98.2, C120.1, C121.2, C122.2, C123.1, C124.2, C125.2, Q1.2 (S), Q2.2 (S), R53.1, R56.1, R69.1, R71.1, R75.2, R76.2, U12.5 (GND), U12.6 (GND__1), U12.7 (GND__2), U12.11 (HEAD), U12.18 (GND__3), U12.19 (GND__4), U12.20 (GND__5), U12.25 (GND__6), U12.26 (GND__7), U12.33 (GND__8), U12.34 (GND__9), U12.41 (GND__10), U12.42 (GND__11), U13.5 (GND), U13.6 (GND__1), U13.7 (GND__2), U13.11 (HEAD), U13.15 (IN2_P), U13.16 (IN2_M), U13.18 (GND__3), U13.19 (GND__4), U13.20 (GND__5), U13.25 (GND__6), U13.26 (GND__7), U13.33 (GND__8), U13.34 (GND__9), U13.41 (GND__10), U13.42 (GND__11); also elsewhere on the board
unnamed: Q1.3 (D), R63.1
unnamed: Q2.3 (D), R64.1
unnamed: R53.2, U12.14 (FREQ_ADJ)
unnamed: R71.2, R72.2, U12.2 (GAIN/SLV)
unnamed: C72.1, R51.1, U12.22 (GVDD)
unnamed: C71.2, U12.9 (IN1_M)
unnamed: C70.2, U12.8 (IN1_P)
unnamed: C74.2, U12.16 (IN2_M)
unnamed: C73.2, U12.15 (IN2_P)
unnamed: C58.1, R64.2, U12.17 (~CMUTE)
unnamed: R54.2, U13.14 (FREQ_ADJ)
unnamed: R56.2, R70.2, U13.2 (GAIN/SLV)
unnamed: C82.1, R55.1, U13.22 (GVDD)
unnamed: C81.2, U13.9 (IN1_M)
unnamed: C80.2, U13.8 (IN1_P)
unnamed: C57.1, R63.2, U13.17 (~CMUTE)
OSCM: U12.12 (OSCM), U13.12 (OSCM)
OSCP: U12.13 (OSCP), U13.13 (OSCP)
RESET: R69.2, U12.10 (~RESET), U13.10 (~RESET); also elsewhere on the board

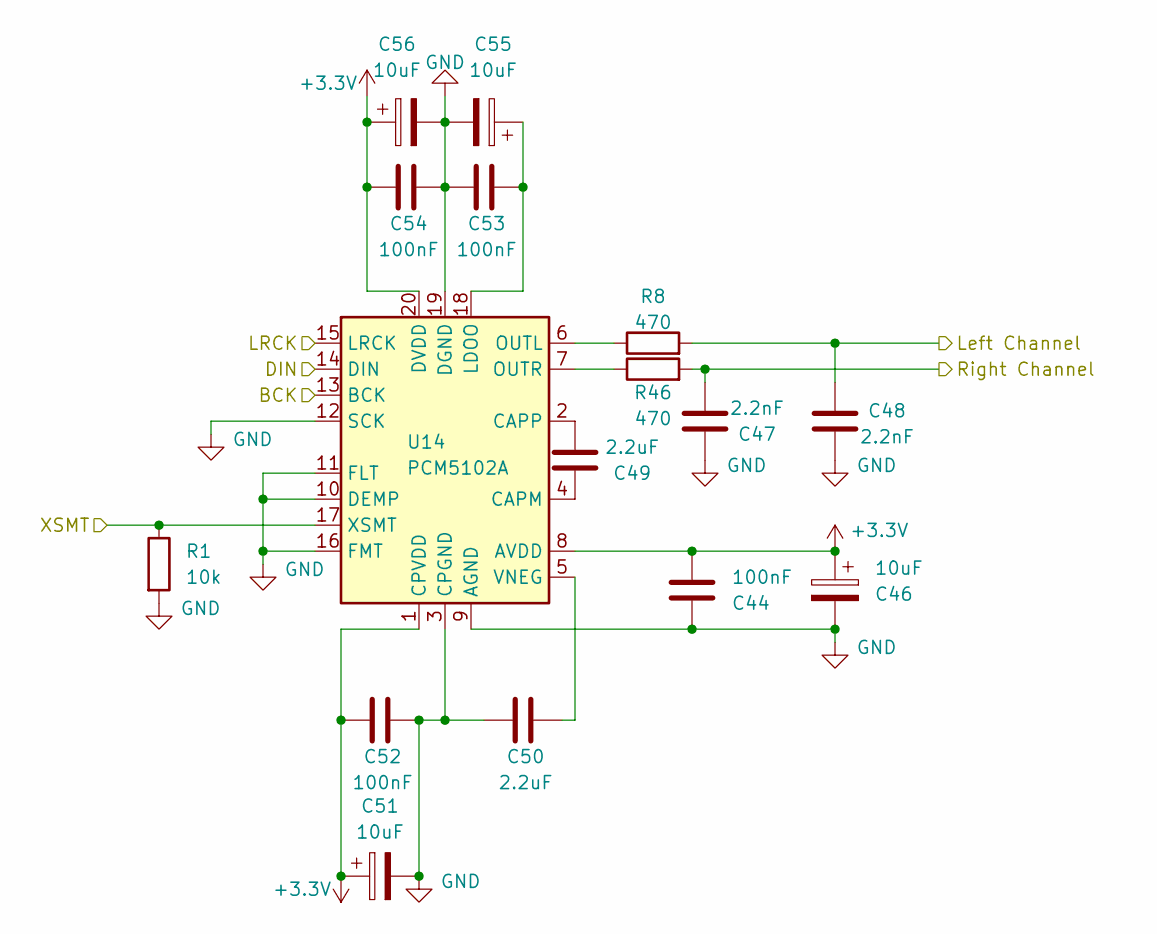
[picture p9: schematic dac.kicad_sch]

Parts:
C44, C52, C53, C54: 100nF; C_0805_2012Metric_Pad1.18x1.45mm_HandSolder; MPN CC0805KRX7R9BB104; LCSC C49678
C46, C51, C55, C56: 10uF; C_0603_1608Metric_Pad1.08x0.95mm_HandSolder; MPN CL10A106KP8NNNC; LCSC C19702
C47, C48: 2.2nF; C_0805_2012Metric_Pad1.18x1.45mm_HandSolder; MPN 0805N222J500CT; LCSC C303929
C49, C50: 2.2uF; C_0603_1608Metric_Pad1.08x0.95mm_HandSolder; MPN CL10A225KO8NNNC; LCSC C23630
R1: 10k; R_0805_2012Metric_Pad1.20x1.40mm_HandSolder; MPN 0805W8F1002T5E; LCSC C17414
R8, R46: 470; R_0805_2012Metric_Pad1.20x1.40mm_HandSolder; MPN 0805W8F4700T5E; LCSC C17710
U14: PCM5102A; TSSOP-20_4.4x6.5mm_P0.65mm; MPN PCM5102APW; LCSC C1520792

Connections:
+3.3V: C44.2, C46.1, C51.1, C52.1, C54.1, C56.1, U14.1 (CPVDD), U14.8 (AVDD), U14.20 (DVDD); also elsewhere on the board
/Microcontroller/Left Channel: C48.1, R8.2; also elsewhere on the board
/Microcontroller/Right Channel: C47.2, R46.2; also elsewhere on the board
BCK: U14.13 (BCK); also elsewhere on the board
DIN: U14.14 (DIN); also elsewhere on the board
GND: C44.1, C46.2, C47.1, C48.2, C50.1, C51.2, C52.2, C53.1, C54.2, C55.2, C56.2, R1.2, U14.3 (CPGND), U14.9 (AGND), U14.10 (DEMP), U14.11 (FLT), U14.12 (SCK), U14.16 (FMT), U14.19 (DGND); also elsewhere on the board
LRCK: U14.15 (LRCK); also elsewhere on the board
unnamed: C49.1, U14.4 (CAPM)
unnamed: C49.2, U14.2 (CAPP)
unnamed: C53.2, C55.1, U14.18 (LDOO)
unnamed: R8.1, U14.6 (OUTL)
unnamed: R46.1, U14.7 (OUTR)
unnamed: C50.2, U14.5 (VNEG)
XSMT: R1.1, U14.17 (XSMT); also elsewhere on the board

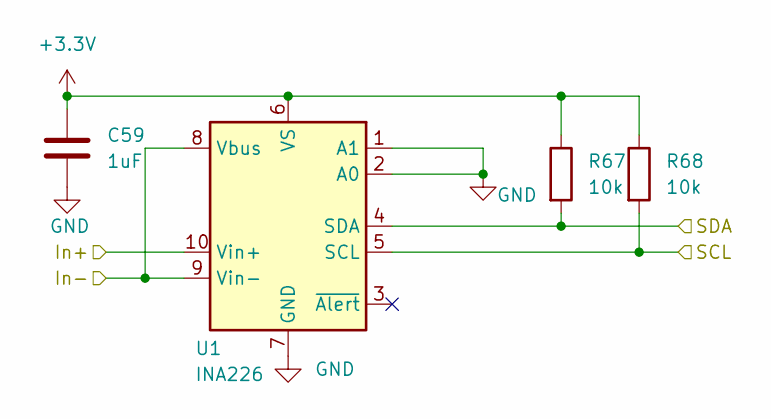
[picture p10: schematic Power measurement.kicad_sch]

Parts:
C59: 1uF; C_0805_2012Metric_Pad1.18x1.45mm_HandSolder; MPN CC0805KKX7R9BB105; LCSC C91185
R67, R68: 10k; R_0805_2012Metric_Pad1.20x1.40mm_HandSolder; MPN 0805W8F1002T5E; LCSC C17414
U1: INA226; TSSOP-10_3x3mm_P0.5mm; MPN INA226AIDGSR; LCSC C49851

Connections:
+3.3V: C59.1, R67.1, R68.1, U1.6 (VS); also elsewhere on the board
/Microcontroller/In+: U1.10 (Vin+); also elsewhere on the board
/Microcontroller/In-: U1.8 (Vbus), U1.9 (Vin-); also elsewhere on the board
GND: C59.2, U1.1 (A1), U1.2 (A0), U1.7 (GND); also elsewhere on the board
SCL: R68.2, U1.5 (SCL); also elsewhere on the board
SDA: R67.2, U1.4 (SDA); also elsewhere on the board

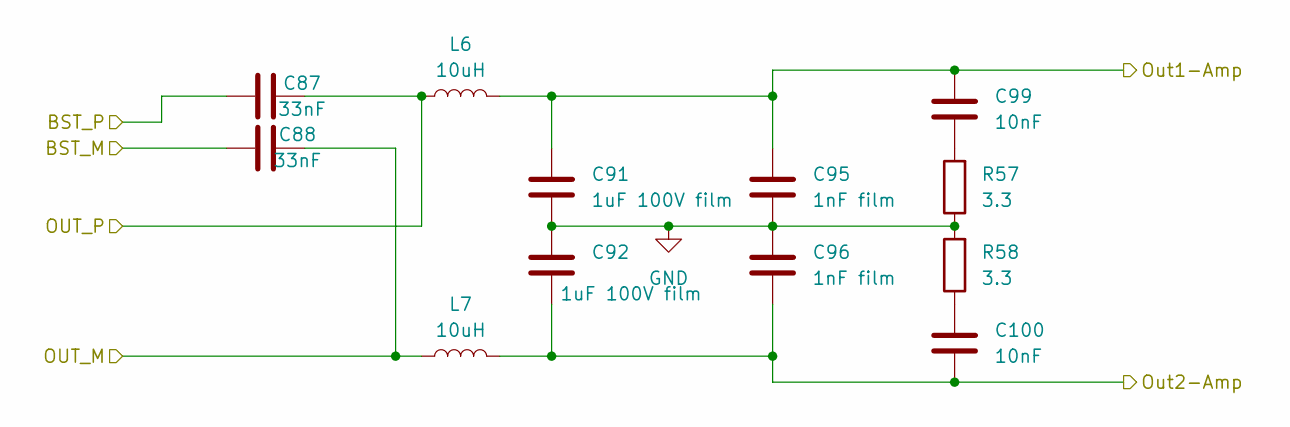
[picture p11: schematic slc.kicad_sch]

Parts:
C87, C88: 33nF; C_0805_2012Metric_Pad1.18x1.45mm_HandSolder; MPN CC0805KRX7R9BB333; LCSC C107150
C91, C92: 1uF 100V film; C_Rect_L10.3mm_W7.2mm_P7.50mm_MKS4; MPN MPE105J100V82CL0042; LCSC C2831916
C95, C96: 1nF film; C_Rect_L7.2mm_W3.5mm_P5.00mm_FKS2_FKP2_MKS2_MKP2; MPN C242A102J20C000; LCSC C280714
C99, C100: 10nF; C_0603_1608Metric_Pad1.08x0.95mm_HandSolder; MPN CC0603KRX7R9BB103; LCSC C100042
L6, L7: 10uH; L_TaiTech_TMPC1265_13.5x12.5mm; MPN TMPC1265HP-100MG-D; LCSC C305223
R57, R58: 3.3; R_0603_1608Metric_Pad0.98x0.95mm_HandSolder; MPN 0603WAF330KT5E; LCSC C22979

Connections:
/Amplifier/Left-1: C91.1, C95.1, C99.2, L6.2; also elsewhere on the board
/Amplifier/Left-2: C92.2, C96.2, C100.1, L7.2; also elsewhere on the board
/Amplifier/Stereo Left Channel/BST_M: C88.1; also elsewhere on the board
/Amplifier/Stereo Left Channel/BST_P: C87.1; also elsewhere on the board
/Amplifier/Stereo Left Channel/OUT_M: C88.2, L7.1; also elsewhere on the board
/Amplifier/Stereo Left Channel/OUT_P: C87.2, L6.1; also elsewhere on the board
GND: C91.2, C92.1, C95.2, C96.1, R57.1, R58.2; also elsewhere on the board
unnamed: C99.1, R57.2
unnamed: C100.2, R58.1

Parts of its further copies:
C90, C101: 33nF; C_0805_2012Metric_Pad1.18x1.45mm_HandSolder; MPN CC0805KRX7R9BB333; LCSC C107150
C102, C103: 1uF 100V film; C_Rect_L10.3mm_W7.2mm_P7.50mm_MKS4; MPN MPE105J100V82CL0042; LCSC C2831916
C104, C105: 1nF film; C_Rect_L7.2mm_W3.5mm_P5.00mm_FKS2_FKP2_MKS2_MKP2; MPN C242A102J20C000; LCSC C280714
C106, C107: 10nF; C_0603_1608Metric_Pad1.08x0.95mm_HandSolder; MPN CC0603KRX7R9BB103; LCSC C100042
L8, L9: 10uH; L_TaiTech_TMPC1265_13.5x12.5mm; MPN TMPC1265HP-100MG-D; LCSC C305223
R59, R60: 3.3; R_0603_1608Metric_Pad0.98x0.95mm_HandSolder; MPN 0603WAF330KT5E; LCSC C22979

Connections of its further copies:
/Amplifier/Right-1: C102.1, C104.1, C106.2, L8.2; also elsewhere on the board
/Amplifier/Right-2: C103.2, C105.2, C107.1, L9.2; also elsewhere on the board
/Amplifier/Stereo Right Channel/BST_M: C101.1; also elsewhere on the board
/Amplifier/Stereo Right Channel/BST_P: C90.1; also elsewhere on the board
/Amplifier/Stereo Right Channel/OUT_M: C101.2, L9.1; also elsewhere on the board
/Amplifier/Stereo Right Channel/OUT_P: C90.2, L8.1; also elsewhere on the board
GND: C102.2, C103.1, C104.2, C105.1, R59.1, R60.2; also elsewhere on the board
unnamed: C106.1, R59.2
unnamed: C107.2, R60.1

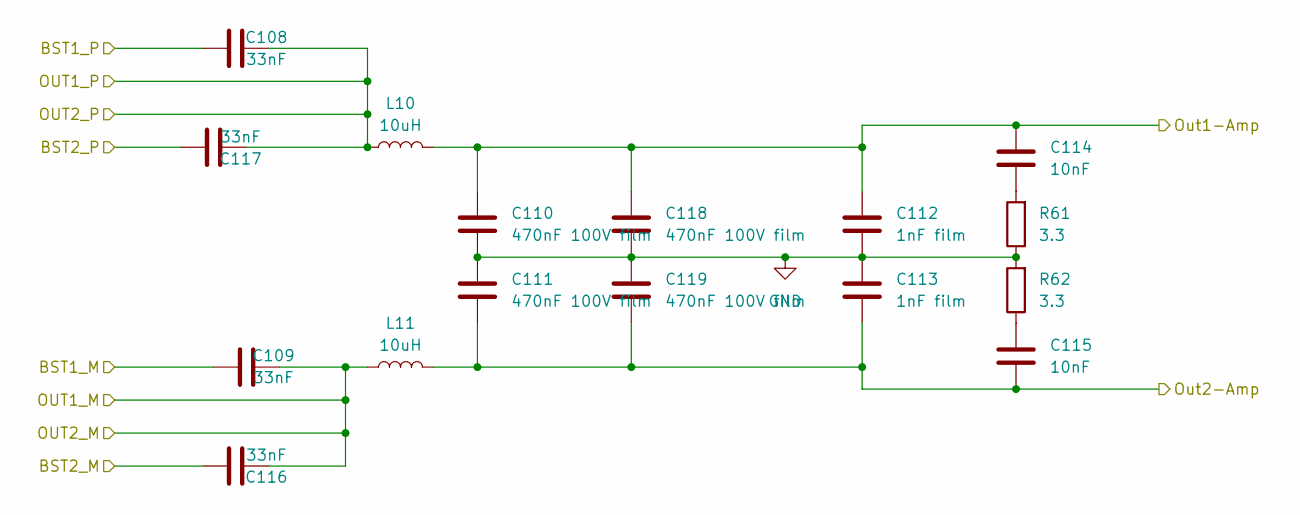
[picture p12: schematic sub.kicad_sch]

Parts:
C108, C109, C116, C117: 33nF; C_0805_2012Metric_Pad1.18x1.45mm_HandSolder; MPN CC0805KRX7R9BB333; LCSC C107150
C110, C111, C118, C119: 470nF 100V film; C_Rect_L10.3mm_W7.2mm_P7.50mm_MKS4; MPN B32560J1474K000; LCSC C125398
C112, C113: 1nF film; C_Rect_L7.2mm_W3.5mm_P5.00mm_FKS2_FKP2_MKS2_MKP2; MPN C242A102J20C000; LCSC C280714
C114, C115: 10nF; C_0603_1608Metric_Pad1.08x0.95mm_HandSolder; MPN CC0603KRX7R9BB103; LCSC C100042
L10, L11: 10uH; L_SXN_SMMS1770; MPN SMMS1770-100M; LCSC C2976967
R61, R62: 3.3; R_0603_1608Metric_Pad0.98x0.95mm_HandSolder; MPN 0603WAF330KT5E; LCSC C22979

Connections:
/Amplifier/Sub-1: C111.2, C113.2, C115.1, C119.2, L11.2; also elsewhere on the board
/Amplifier/Sub-2: C110.1, C112.1, C114.2, C118.1, L10.2; also elsewhere on the board
/Amplifier/Subwoofer/BST1_M: C109.1; also elsewhere on the board
/Amplifier/Subwoofer/BST1_P: C108.1; also elsewhere on the board
/Amplifier/Subwoofer/BST2_M: C116.1; also elsewhere on the board
/Amplifier/Subwoofer/BST2_P: C117.1; also elsewhere on the board
/Amplifier/Subwoofer/OUT1_M: C109.2, C116.2, L11.1; also elsewhere on the board
/Amplifier/Subwoofer/OUT1_P: C108.2, C117.2, L10.1; also elsewhere on the board
GND: C110.2, C111.1, C112.2, C113.1, C118.2, C119.1, R61.1, R62.2; also elsewhere on the board
unnamed: C114.1, R61.2
unnamed: C115.2, R62.1

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
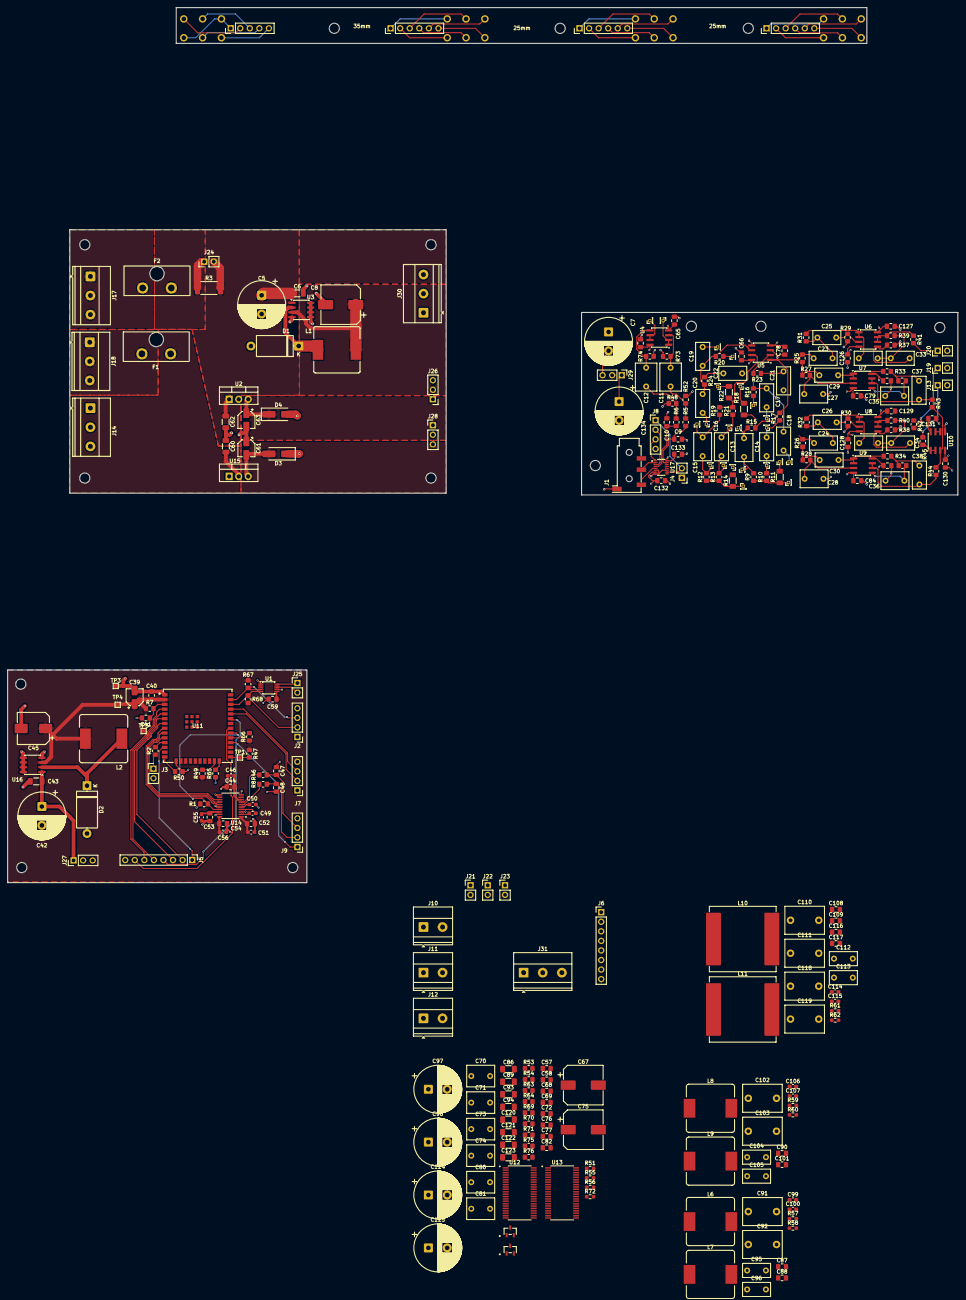
[picture p13: board SoundSystem.kicad_pcb from above]

Board: 4 copper layers, 275 parts (0 on the bottom side), 169 nets.
