saper6569/Sound-System/(commit log)

2026-07-30 subwoofer fix
    [SoundSystem.kicad_sch, amp.kicad_sch, esp32.kicad_sch, sub.kicad_sch]
2026-08-03 moved dac to input path and added input multiplexing
    [EQ.kicad_sch, Power measurement.kicad_sch, SoundSystem.kicad_sch, amp.kicad_sch, crossover.kicad_sch, dac.kicad_sch, esp32.kicad_sch, input.kicad_sch]
2026-08-12 final schematic
    [EQ.kicad_sch, crossover.kicad_sch, dac.kicad_sch, esp32.kicad_sch, input.kicad_sch, psu.kicad_sch]
2026-08-13 fixed issues in amp
    [amp.kicad_sch, esp32.kicad_sch, input.kicad_sch]
2026-09-16 added buses to split the pcb into 4
2026-11-11 finalized schematic
    Finished lcsc part order so all footprints are now final.
2026-11-11 pcb footprint placement init
2026-11-13 completed power system, and updated 3d models
